steiger-systems/TempWatch/V1/Output-Files/BOM-JLCPCB Assembly Order.xls

JLCPCB BOM Tool - BOM Matching
BOM name：BOM-JLCPCB Assembly Order.xlsx |  |  | Download Time：2026-01-14 13:53:26 |  |  |  | * Our matching results are updated in real-time, but stock and prices may change. If it's been over 24 hours, please re-match before placing your order.
PCB Assembled Qty：5 |  |  | Est. Total Price：63.9846
Your BOM |  |  |  |  | Matched Parts |  |  |  |  |  |  | Order Information
Top Designator | Bottom Designator | Comment | Footprint | JLCPCB Part # | Matches | Part # | Manufacturer | Footprint | Description | Category | Warning | JLCPCB Part # | Product link | Lib Type | Qty | Source | Total Price ($)
C1,C2 |  | 22pF | C0603 |  | Select by System | CL10C220JB8NNNC | Samsung Electro-Mechanics | 0603 | 22pF 50V C0G ±5% 0603 Multilayer Ceramic Capacitors MLCC - SMD/SMT ROHS | Multilayer Ceramic Capacitors MLCC - SMD/SMT |  | C1653 | https://jlcpcb.com/partdetail/2005-CL10C220JB8NNNC/C1653 | Basic | 20 | 20 JLCPCB | 0.082
C5 |  | 22uF | CAP-SMD_BD4.0-L4.3-W4.3-LS5.1-FD |  | Select by System | VZH220M1CTR-0406 | Lelon | SMD,D4xL5.7mm | -45℃~+105℃ 16V 2000hrs@105℃ 22uF 4mm 5.7mm ±20% SMD,D4xL5.7mm Aluminum Electrolytic Capacitors - SMD ROHS | Aluminum Electrolytic Capacitors - SMD |  | C176685 | https://jlcpcb.com/partdetail/Lelon-VZH220M1CTR0406/C176685 | Extended | 9 | 9 JLCPCB | 0.6003
C7,C4,C11,C3,C6 |  | 100nF | C0603 |  | Select by System | CC0603KRX7R9BB104 | YAGEO | 0603 | 100nF 50V X7R ±10% 0603 Multilayer Ceramic Capacitors MLCC - SMD/SMT ROHS | Multilayer Ceramic Capacitors MLCC - SMD/SMT |  | C14663 | https://jlcpcb.com/partdetail/YAGEO-CC0603KRX7R9BB104/C14663 | Basic | 35 | 35 JLCPCB | 0.0875
C8 |  | 47uF | C0603 |  | Select by System | GRM188R60J476ME15D | Murata Electronics | 0603 | 47uF 6.3V X5R ±20% 0603 Multilayer Ceramic Capacitors MLCC - SMD/SMT ROHS | Multilayer Ceramic Capacitors MLCC - SMD/SMT |  | C140782 | https://jlcpcb.com/partdetail/152108-GRM188R60J476ME15D/C140782 | Extended | 9 | 9 JLCPCB | 0.4959
C9 |  | 430pF | C0402 |  | Select by System | 0402N431J500CT | Walsin Tech Corp | 0402 | 430pF 50V NP0 ±5% 0402 Multilayer Ceramic Capacitors MLCC - SMD/SMT ROHS | Multilayer Ceramic Capacitors MLCC - SMD/SMT |  | C458865 | https://jlcpcb.com/partdetail/Walsin_TechCorp-0402N431J500CT/C458865 | Extended | 20 | 20 JLCPCB | 0.086
C10 |  | 10uF | C1206 |  | Select by System | CL31A106KBHNNNE | Samsung Electro-Mechanics | 1206 | 10uF 50V X5R ±10% 1206 Multilayer Ceramic Capacitors MLCC - SMD/SMT ROHS | Multilayer Ceramic Capacitors MLCC - SMD/SMT |  | C13585 | https://jlcpcb.com/partdetail/14236-CL31A106KBHNNNE/C13585 | Basic | 9 | 9 JLCPCB | 0.5319
C16,C15,C14 |  | 1uF | C0805 |  | Select by System | CL21B105KBFNNNE | Samsung Electro-Mechanics | 0805 | 1uF 50V X7R ±10% 0805 Multilayer Ceramic Capacitors MLCC - SMD/SMT ROHS | Multilayer Ceramic Capacitors MLCC - SMD/SMT |  | C28323 | https://jlcpcb.com/partdetail/29074-CL21B105KBFNNNE/C28323 | Basic | 25 | 25 JLCPCB | 0.2325
CN2,CN7,CN5,CN1,CN6,CN3,CN4,CN8 |  | SM03B-SRSS-TB(LF)(SN)(P) | CONN-SMD_SM03B-SRSS-TB-LF-SN-P |  | Select by Customer | SM03B-SRSS-TB(LF)(SN) | JST | SMD,P=1mm,卧贴 | -25℃~+85℃ 1 1A 1mm 1x3P 2.9mm 3 3P 4.32mm 50V 5mm Auxiliary Solder Pin Copper alloy PA SH Surface Mount, Right Angle Tin UL94V-0 White SMD,P=1mm,Surface Mount，Right Angle Wire To Board Connector ROHS | Wire To Board Connector |  | C160403 | https://jlcpcb.com/partdetail/JST-SM03B_SRSS_TB_LF_SN/C160403 | Extended | 42 | 42 JLCPCB | 7.203
CN10 |  | SM04B-SRSS-TB(LF)(SN) | CONN-SMD_4P-P1.00_SM04B-SRSS-TB-LF-SN |  | Select by System | SM04B-SRSS-TB(LF)(SN) | JST | SMD,P=1mm,卧贴 | -25℃~+85℃ 1 1A 1mm 1x4P 2.9mm 4 4.32mm 4P 50V 6mm Auxiliary Solder Pin Copper alloy PA SH Surface Mount, Right Angle Tin UL94V-0 White SMD,P=1mm,Surface Mount，Right Angle Wire To Board Connector ROHS | Wire To Board Connector |  | C160404 | https://jlcpcb.com/partdetail/JST-SM04B_SRSS_TB_LF_SN/C160404 | Extended | 5 | 5 JLCPCB | 0.976
CN11 |  | SM02B-PASS-1-TBT(LF)(SN) | CONN-SMD_SM02B-PASS-1-TBT-LF-SN |  | Select by System | SM02B-PASS-1-TBT(LF)(SN) | JST | SMD,P=2mm,卧贴 | -25℃~+85℃ 1 1x2P 2 250V 2P 2mm 3A 5.7mm 8mm Copper alloy PA PA Pillar、Auxiliary Solder Pin Surface Mount, Right Angle Tin UL94V-0 White SMD,P=2mm,Surface Mount，Right Angle Wire To Board Connector ROHS | Wire To Board Connector |  | C265416 | https://jlcpcb.com/partdetail/JST-SM02B_PASS_1_TBT_LF_SN/C265416 | Extended | 5 | 5 JLCPCB | 1.8865
D1 |  | B340A-13-F | SMA_L4.4-W2.6-LS5.0-RD |  | Select by System | B340A-13-F | Diodes Incorporated | SMA(DO-214AC) | -55℃~+150℃ 1 Independent 3A 40V 500mV@3A 500uA@40V 80A SMA(DO-214AC) Schottky Diodes ROHS | Schottky Diodes |  | C85098 | https://jlcpcb.com/partdetail/DiodesIncorporated-B340A_13F/C85098 | Extended | 9 | 9 JLCPCB | 0.5229
Q2,Q1 |  | BC817-25Q-7-F | SOT-23-3_L2.9-W1.3-P1.90-LS2.4-BR |  | Select by System | BC817-25Q-7-F | Diodes Incorporated | SOT-23 | -65℃~+150℃ 100@300mA,1.0V 100MHz 100nA 350mW 45V 500mA 5V 700mV NPN SOT-23 Bipolar (BJT) ROHS | Bipolar (BJT) |  | C559579 | https://jlcpcb.com/partdetail/DiodesIncorporated-BC817_25Q_7F/C559579 | Extended | 14 | 14 JLCPCB | 0.371
R2,R4,R7,R5,R1,R3,R8,R6 |  | 4.7k | R0603 |  | Select by Customer | FRC0603F4701TS | FOJAN | 0603 | -55℃~+155℃ 100mW 4.7kΩ 75V Thick Film Resistor ±1% ±100ppm/℃ 0603 Chip Resistor - Surface Mount ROHS | Chip Resistor - Surface Mount | 1.The comment (FRC0603F4701TS) of this part does not match the one (4.7k) provided in your BOM. Please confirm; | C2907034 | https://jlcpcb.com/partdetail/FOJAN-FRC0603F4701TS/C2907034 | Extended | 50 | 50 JLCPCB | 0.045
R10,R9,R19,R11,R18 |  | 100k | R0402 |  | Select by Customer | CRCW0402100KFKED | Vishay Intertech | 0402 | -55℃~+155℃ 100kΩ 50V 63mW Thick Film Resistor ±1% ±100ppm/℃ 0402 Chip Resistor - Surface Mount ROHS | Chip Resistor - Surface Mount | 1.The comment (CRCW0402100KFKED) of this part does not match the one (100k) provided in your BOM. Please confirm; | C481918 | https://jlcpcb.com/partdetail/VishayIntertech-CRCW0402100KFKED/C481918 | Extended | 35 | 35 JLCPCB | 0.1225
R14,R15 |  | 5.1k | R0603 |  | Select by Customer | 0603WAF5101T5E | UNI-ROYAL(Uniroyal Elec) | 0603 | -55℃~+155℃ 100mW 5.1kΩ 75V Thick Film Resistor ±1% ±100ppm/℃ 0603 Chip Resistor - Surface Mount ROHS | Chip Resistor - Surface Mount | 1.The comment (0603WAF5101T5E) of this part does not match the one (5.1k) provided in your BOM. Please confirm; | C23186 | https://jlcpcb.com/partdetail/23913-0603WAF5101T5E/C23186 | Basic | 20 | 20 JLCPCB | 0.022
R17,R12,R16,R13 |  | 10k | R0603 |  | Select by Customer | 0603WAF1002T5E | UNI-ROYAL(Uniroyal Elec) | 0603 | -55℃~+155℃ 100mW 10kΩ 75V Thick Film Resistor ±1% ±100ppm/℃ 0603 Chip Resistor - Surface Mount ROHS | Chip Resistor - Surface Mount | 1.The comment (0603WAF1002T5E) of this part does not match the one (10k) provided in your BOM. Please confirm; | C25804 | https://jlcpcb.com/partdetail/26547-0603WAF1002T5E/C25804 | Basic | 30 | 30 JLCPCB | 0.033
R20 |  | 309k | R0402 |  | Select by Customer | FRC0402F3093TS | FOJAN | 0402 | -55℃~+155℃ 309kΩ 50V 62.5mW Thick Film Resistor ±1% ±100ppm/℃ 0402 Chip Resistor - Surface Mount ROHS | Chip Resistor - Surface Mount | 1.The comment (FRC0402F3093TS) of this part does not match the one (309k) provided in your BOM. Please confirm; | C5713270 | https://jlcpcb.com/partdetail/FOJAN-FRC0402F3093TS/C5713270 | Extended | 20 | 20 JLCPCB | 0.01
R21 |  | 10 | R0603 |  | Select by Customer | ERJ3GEYJ100V | PANASONIC | 0603 | -55℃~+155℃ 100mW 10Ω 75V Thick Film Resistor ±200ppm/℃ ±5% 0603 Chip Resistor - Surface Mount ROHS | Chip Resistor - Surface Mount | 1.The comment (ERJ3GEYJ100V) of this part does not match the one (10) provided in your BOM. Please confirm; | C403411 | https://jlcpcb.com/partdetail/PANASONIC-ERJ3GEYJ100V/C403411 | Extended | 20 | 20 JLCPCB | 0.106
R26,R24 |  | 0 | R1206 |  | Select by Customer | FRC1206P000 TS | FOJAN | 1206 | -55℃~+155℃ 0Ω 200V 250mW Thick Film Resistor ±5% 1206 Chip Resistor - Surface Mount ROHS | Chip Resistor - Surface Mount | 1.The comment (FRC1206P000 TS) of this part does not match the one (0) provided in your BOM. Please confirm; | C2907406 | https://jlcpcb.com/partdetail/FOJAN-FRC1206P000TS/C2907406 | Extended | 20 | 20 JLCPCB | 0.04
SW2,SW1 |  | KH-6X6X5H-STM | SW-SMD_4P-L6.0-W6.0-P4.50-LS9.0_H5.0 |  | Select by System | KH-6X6X5H-STM | Shenzhen Kinghelm Elec | SMD-4P,6x6mm | 12V 50mA 5mm 6mm 6mm 80,000 cycles Black Gull Wing Round Button SPST Surface Mount,Vertical Without Bracket SMD-4P,6x6mm Tactile Switches ROHS | Tactile Switches |  | C2837531 | https://jlcpcb.com/partdetail/Shenzhen_KinghelmElec-KH_6X6X5HSTM/C2837531 | Extended | 11 | 11 JLCPCB | 0.1881
U1 |  | MCP2515-I/ST | TSSOP-20_L6.5-W4.4-P0.65-LS6.4-BL |  | Select by System | MCP2515-I/ST | Microchip Tech | TSSOP-20 | -40℃~+85℃ 1Mbps 2.7V~5.5V 5mA CAN Controller TSSOP-20 CAN Controllers ROHS | CAN Controllers |  | C15193 | https://jlcpcb.com/partdetail/MicrochipTech-MCP2515_IST/C15193 | Extended | 5 | 5 JLCPCB | 8.234
U2 |  | SN65HVD230D | SOIC-8_L4.9-W3.9-P1.27-LS6.0-BL |  | Select by System | SN65HVD230D | Texas Instruments | SOIC-8 | -40℃~+85℃ 17mA 1Mbps 370uA 3V~3.6V CAN Transceiver SOIC-8 CAN Transceivers ROHS | CAN Transceivers |  | C1543812 | https://jlcpcb.com/partdetail/TexasInstruments-SN65HVD230D/C1543812 | Extended | 5 | 5 JLCPCB | 3.3655
U4 |  | ESP32-S3-WROOM-1(N8R2) | WIRELM-SMD_ESP32-S3-WROOM-1 |  | Unconfirmed | ESP32-S3-WROOM-1-N8R2 | Espressif Systems | SMD,25.5x18mm | -40℃~+85℃ -98.2dBm 2.4GHz 20.5dBm 355mA 3V~3.6V 97mA Bluetooth5.0 ESP32-S3 Chip On-board PCB Antenna UART、SPI、I2C、I2S、USB SMD,25.5x18mm WiFi Modules ROHS | WiFi Modules | 1.The comment (ESP32-S3-WROOM-1-N8R2) of this part does not match the one (ESP32-S3-WROOM-1(N8R2)) provided in your BOM. Please confirm; | C2913204 | https://jlcpcb.com/partdetail/3198302-ESP32_S3_WROOM_1N8R2/C2913204 | Extended | 5 | 5 JLCPCB | 23.5345
U5 |  | YTC-TC16S-24 | USB-C-SMD_YTC-TC16S-24 |  | Select by System | YTC-TC16S-24 | YIYUAN | SMD | -20℃~+85℃ 1 16P 3A、5A 5,000 times、10,000 cycles 5V 7.3mm Female Surface Mount, Right Angle Type-C SMD USB Connectors ROHS | USB Connectors |  | C2927291 | https://jlcpcb.com/partdetail/YIYUAN-YTC_TC16S24/C2927291 | Extended | 5 | 5 JLCPCB | 0.649
U6 |  | CP2102N-A02-GQFN28R | QFN-28_L5.0-W5.0-P0.50-TL-EP3.3 |  | Select by System | CP2102N-A02-GQFN28R | SKYWORKS/SILICON LABS | QFN-28-EP(5x5) | -40℃~+85℃@(Ta) 1.3uA 3V~3.6V 9.5mA USB 2.0 USB to UART QFN-28-EP(5x5) USB Converters ROHS | USB Converters |  | C964632 | https://jlcpcb.com/partdetail/1049893-CP2102N_A02GQFN28R/C964632 | Extended | 5 | 5 JLCPCB | 7.9835
U7 |  | TPS82130SILR | USIP-8_L3.0-W2.8-P0.65-TL-EP |  | Select by System | TPS82130SILR | Texas Instruments | USIP-8 | -40℃~+125℃ 1 1.5mm 2.8mm 20uA 2MHz 3A 3V~17V 3mm 900mV~6V Buck Over Temperature Protection ±1.5% USIP-8 DC-DC Power Modules ROHS | DC-DC Power Modules |  | C473914 | https://jlcpcb.com/partdetail/TexasInstruments-TPS82130SILR/C473914 | Extended | 5 | 5 JLCPCB | 4.8995
U9 |  | H7651-33PR | SOT-89-3_L4.5-W2.5-P1.50-LS4.1-BR |  | Select by System | H7651-33PR | Shanghai Siproin Microelectronics | SOT-89-3 | -40℃~+85℃ 1 1A 2uA 3.3V 60mV@(100mA) 8V Fixed Over Current Protection、Over Temperature Protection、Thermal Shutdown Positive SOT-89-3 Voltage Regulators - Linear, Low Drop Out (LDO) Regulators ROHS | Voltage Regulators - Linear, Low Drop Out (LDO) Regulators |  | C411050 | https://jlcpcb.com/partdetail/402215-H765133PR/C411050 | Extended | 7 | 7 JLCPCB | 0.8442
X2 |  | 10MHz | CRYSTAL-SMD_4P-L3.2-W2.5-BL |  | Select by System | T322510MLBDE2X | Yajingxin | SMD3225-4P | -30℃~+85℃ 10MHz 20pF 80Ω Crystal Oscillator ±10ppm ±30ppm SMD3225-4P Crystals ROHS | Crystals |  | C20885049 | https://jlcpcb.com/partdetail/Yajingxin-T322510MLBDE2X/C20885049 | Extended | 7 | 7 JLCPCB | 0.8323
H1 |  | 1x6 | HDR-TH_6P-P2.54-V-M-1 |  | Unconfirmed | 10897061 | MOLEX | 插件,P=2.54mm | 2 2.29mm 2.54mm 2.54mm 2.71mm 6.1mm 6P Black Copper alloy Pin Header Through Hole Tin Plugin,P=2.54mm Pin Headers ROHS | Pin Headers | 1.The comment (10897061) of this part does not match the one (1x6) provided in your BOM. Please confirm; | C3327513 | https://jlcpcb.com/partdetail/MOLEX-10897061/C3327513 | Extended | 5 | 0 JLCPCB | 0
