steiger-systems/TempWatch/V1/TempWatchtV1.kicad_pcb

## KiCad design V1/TempWatchtV1.kicad_pcb (2026-01-19)

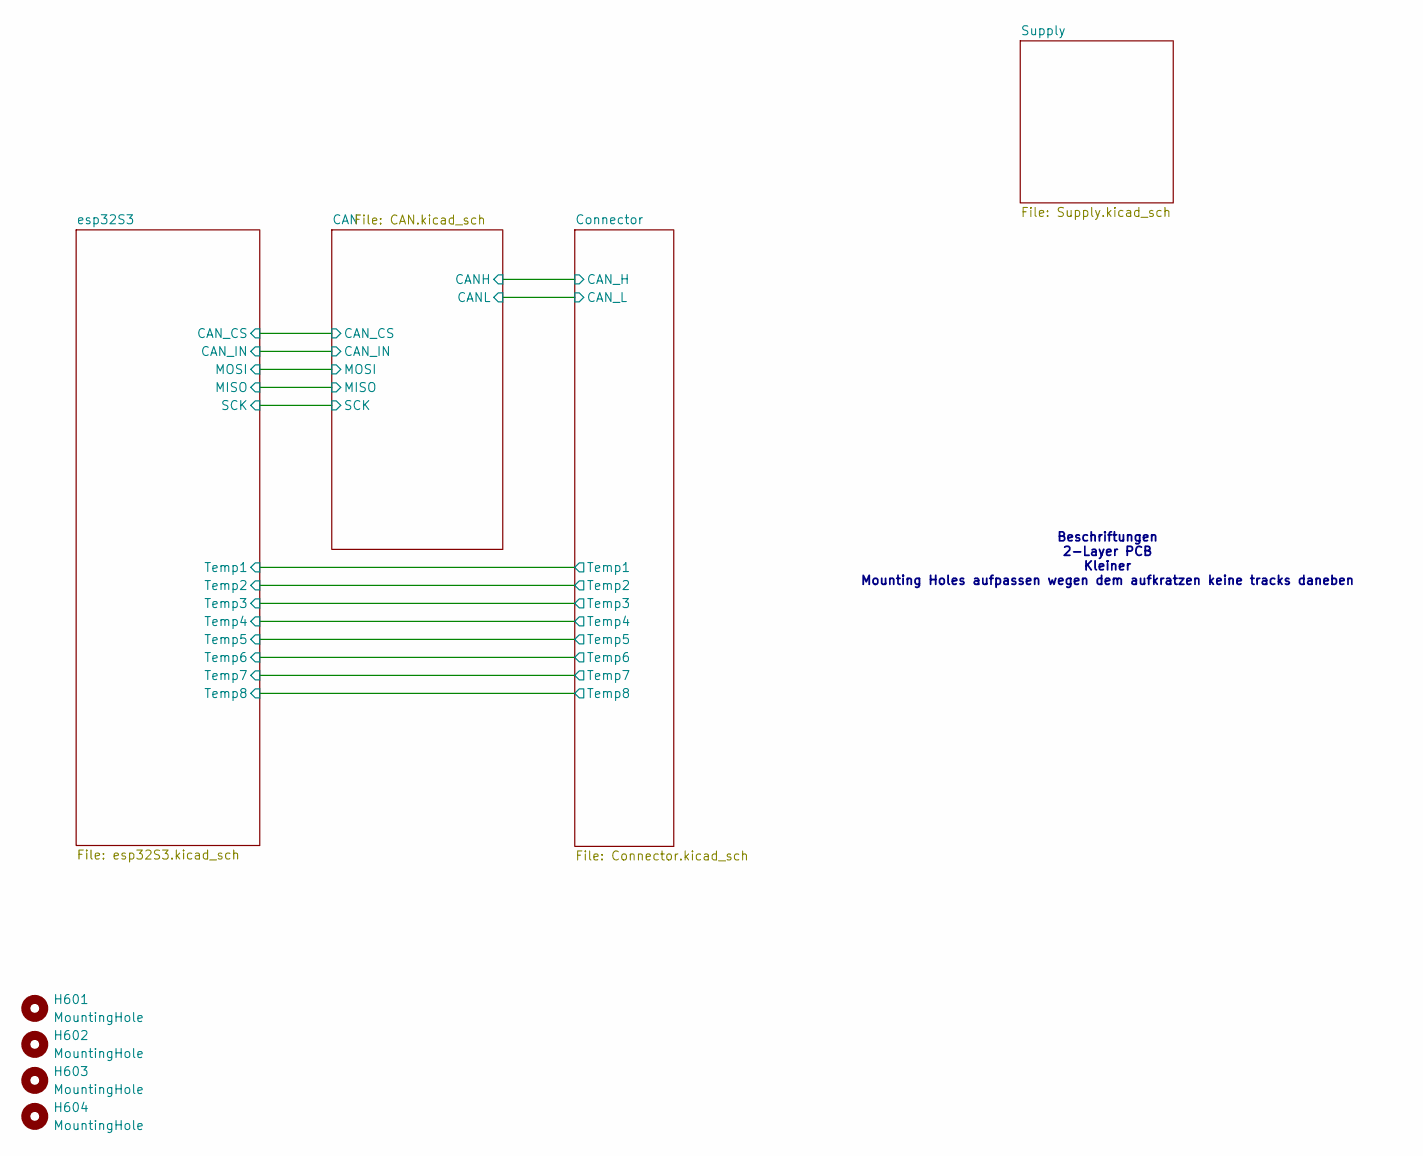
[picture p1: schematic TempWatchtV1.kicad_sch]

Parts:
H601, H602, H603, H604: MountingHole; MountingHole_3.2mm_M3_DIN965

Notes on the sheet:
Beschriftungen 2-Layer PCB Kleiner Mounting Holes aufpassen wegen dem aufkratzen keine tracks daneben

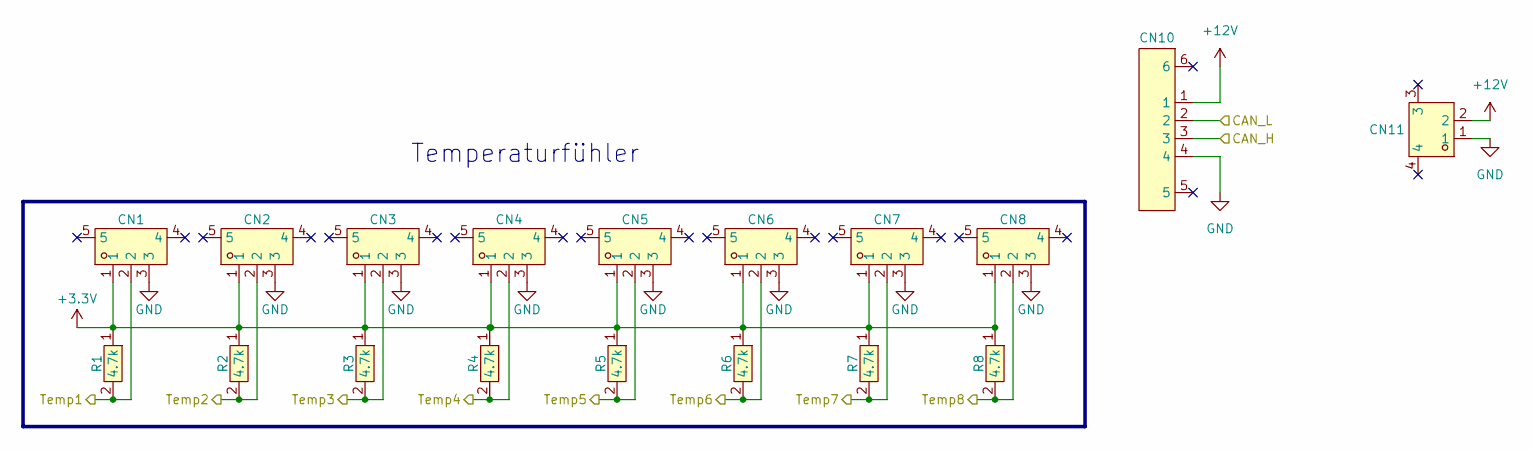
[picture p2: schematic Connector.kicad_sch]

Parts:
CN1, CN2, CN3, CN4, CN5, CN6, CN7, CN8: SM03B-SRSS-TB(LF)(SN)(P); CONN-SMD_SM03B-SRSS-TB-LF-SN-P; LCSC Part C160403
CN10: SM04B-SRSS-TB (LF)(SN); CONN-SMD_4P-P1.00_SM04B-SRSS-TB-LF-SN; LCSC Part C160404
CN11: SM02B-PASS-1-TBT(LF)(SN); CONN-SMD_SM02B-PASS-1-TBT-LF-SN; LCSC Part C265416
R1, R2, R3, R4, R5, R6, R7, R8: 4.7k; R0603; LCSC Part C2907034

Connections:
+3.3V: CN1.1, CN2.1, CN3.1, CN4.1, CN5.1, CN6.1, CN7.1, CN8.1, R1.1, R2.1, R3.1, R4.1, R5.1, R6.1, R7.1, R8.1; also elsewhere on the board
+12V: CN10.1, CN11.2; also elsewhere on the board
/CAN/CANH: CN10.3; also elsewhere on the board
/CAN/CANL: CN10.2; also elsewhere on the board
/Connector/Temp1: CN1.2, R1.2; also elsewhere on the board
/Connector/Temp2: CN2.2, R2.2; also elsewhere on the board
/Connector/Temp3: CN3.2, R3.2; also elsewhere on the board
/Connector/Temp4: CN4.2, R4.2; also elsewhere on the board
/Connector/Temp5: CN5.2, R5.2; also elsewhere on the board
/Connector/Temp6: CN6.2, R6.2; also elsewhere on the board
/Connector/Temp7: CN7.2, R7.2; also elsewhere on the board
/Connector/Temp8: CN8.2, R8.2; also elsewhere on the board
GND: CN1.3, CN2.3, CN3.3, CN4.3, CN5.3, CN6.3, CN7.3, CN8.3, CN10.4, CN11.1; also elsewhere on the board

Notes on the sheet:
Temperaturfühler

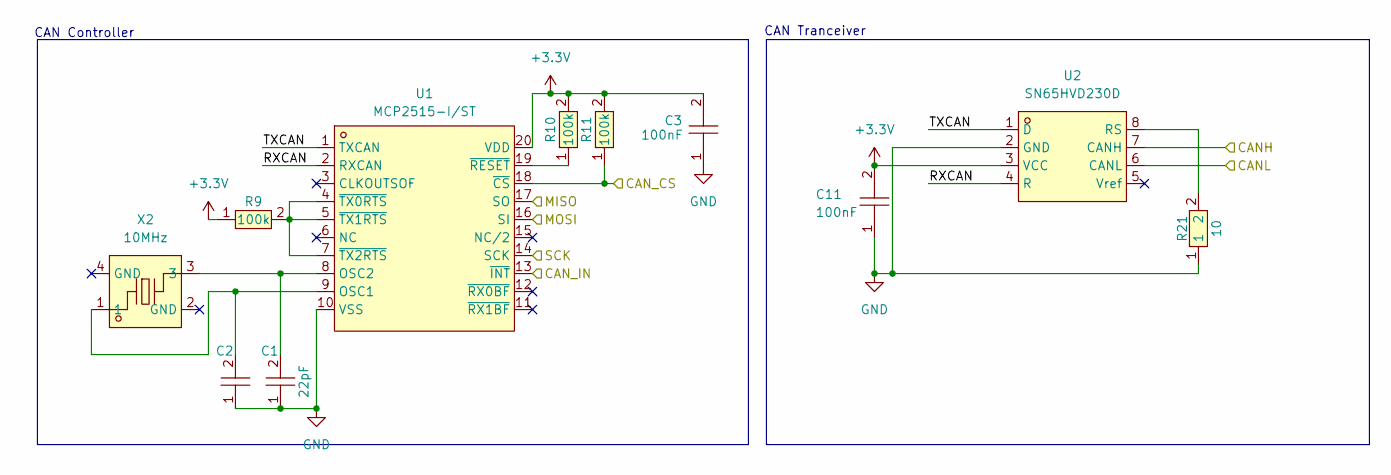
[picture p3: schematic CAN.kicad_sch]

Parts:
C1, C2: 22pF; C0603; LCSC Part C105620
C3, C11: 100nF; C0603; LCSC Part C14663
R9, R10, R11: 100k; R0402; LCSC Part C481918
R21: 10; R0603; LCSC Part C403411
U1: MCP2515-I/ST; TSSOP-20_L6.5-W4.4-P0.65-LS6.4-BL; LCSC Part C15193
U2: SN65HVD230D; SOIC-8_L4.9-W3.9-P1.27-LS6.0-BL; LCSC Part C1543812
X2: 10MHz; CRYSTAL-SMD_4P-L3.2-W2.5-BL; LCSC Part C20885034

Connections:
+3.3V: C3.2, C11.2, R9.1, R10.2, R11.2, U1.20 (VDD), U2.3 (VCC); also elsewhere on the board
/CAN/CANH: U2.7 (CANH); also elsewhere on the board
/CAN/CANL: U2.6 (CANL); also elsewhere on the board
/CAN/CAN_CS: R11.1, U1.18 (~CS); also elsewhere on the board
/CAN/CAN_IN: U1.13 (~INT); also elsewhere on the board
/CAN/MISO: U1.17 (SO); also elsewhere on the board
/CAN/MOSI: U1.16 (SI); also elsewhere on the board
/CAN/RXCAN: U1.2 (RXCAN), U2.4 (R)
/CAN/SCK: U1.14 (SCK); also elsewhere on the board
/CAN/TXCAN: U1.1 (TXCAN), U2.1 (D)
GND: C1.1, C2.1, C3.1, C11.1, R21.1, U1.10 (VSS), U2.2 (GND); also elsewhere on the board
unnamed: C2.2, U1.9 (OSC1), X2.1
unnamed: C1.2, U1.8 (OSC2), X2.3
unnamed: R10.1, U1.19 (~RESET)
unnamed: R9.2, U1.4 (~TX0RTS), U1.5 (~TX1RTS), U1.7 (~TX2RTS)
unnamed: R21.2, U2.8 (RS)

Notes on the sheet:
CAN Tranceiver
CAN Controller

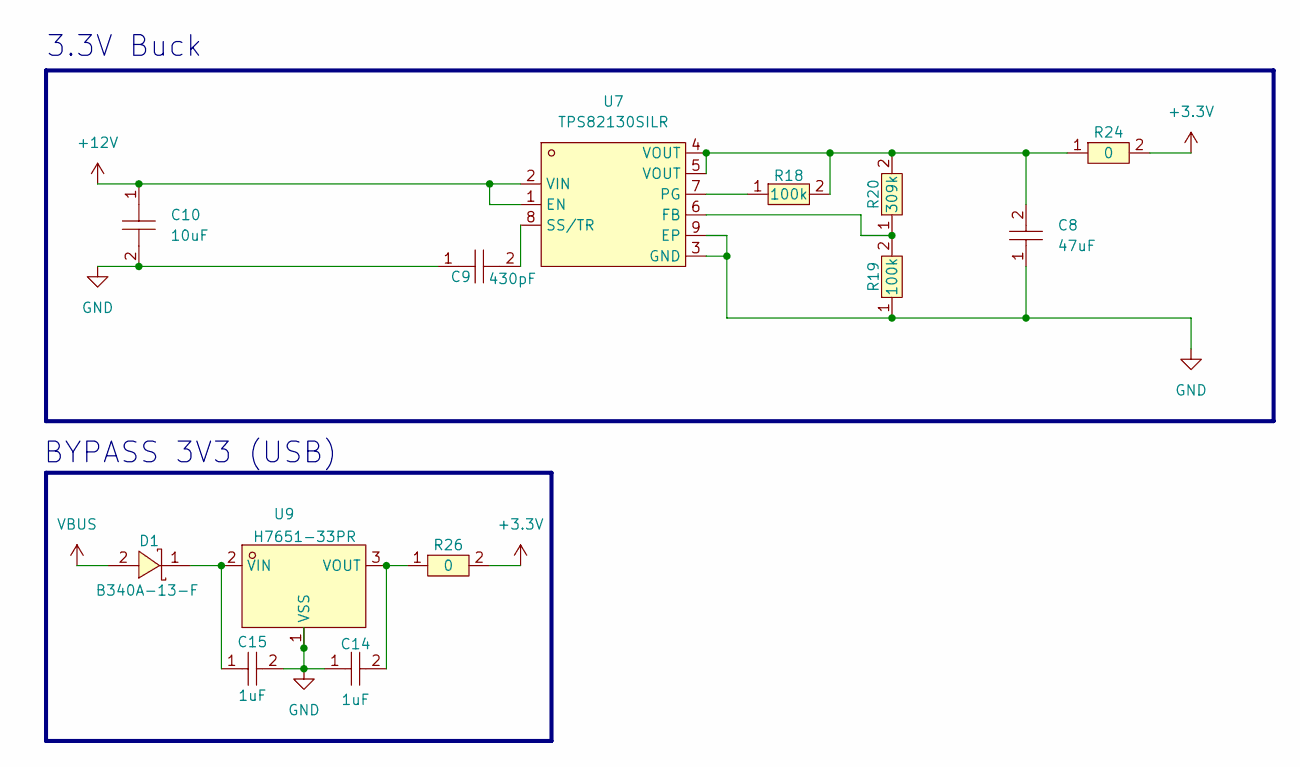
[picture p4: schematic Supply.kicad_sch]

Parts:
C8: 47uF; C0603; LCSC Part C140782
C9: 430pF; C0402; LCSC Part C2193561
C10: 10uF; C1206; LCSC Part C89632
C14, C15: 1uF; C0805; LCSC Part C28323
D1: B340A-13-F; SMA_L4.4-W2.6-LS5.0-RD; LCSC Part C85098
R18, R19: 100k; R0402; LCSC Part C481918
R20: 309k; R0402; LCSC Part C5713270
R24, R26: 0; R1206; LCSC Part C2907406
U7: TPS82130SILR; USIP-8_L3.0-W2.8-P0.65-TL-EP; LCSC Part C473914
U9: H7651-33PR; SOT-89-3_L4.5-W2.5-P1.50-LS4.1-BR; LCSC Part C411050

Connections:
+3.3V: R24.2, R26.2; also elsewhere on the board
+12V: C10.1, U7.1 (EN), U7.2 (VIN); also elsewhere on the board
GND: C8.1, C9.1, C10.2, C14.1, C15.2, R19.1, U7.3 (GND), U7.9 (EP), U9.1 (VSS); also elsewhere on the board
unnamed: C8.2, R18.2, R20.2, R24.1, U7.4 (VOUT), U7.5 (VOUT)
unnamed: C15.1, D1.1 (K), U9.2 (VIN)
unnamed: R19.2, R20.1, U7.6 (FB)
unnamed: R18.1, U7.7 (PG)
unnamed: C9.2, U7.8 (SS/TR)
unnamed: C14.2, R26.1, U9.3 (VOUT)
VBUS: D1.2 (A); also elsewhere on the board

Notes on the sheet:
BYPASS 3V3 (USB)
3.3V Buck

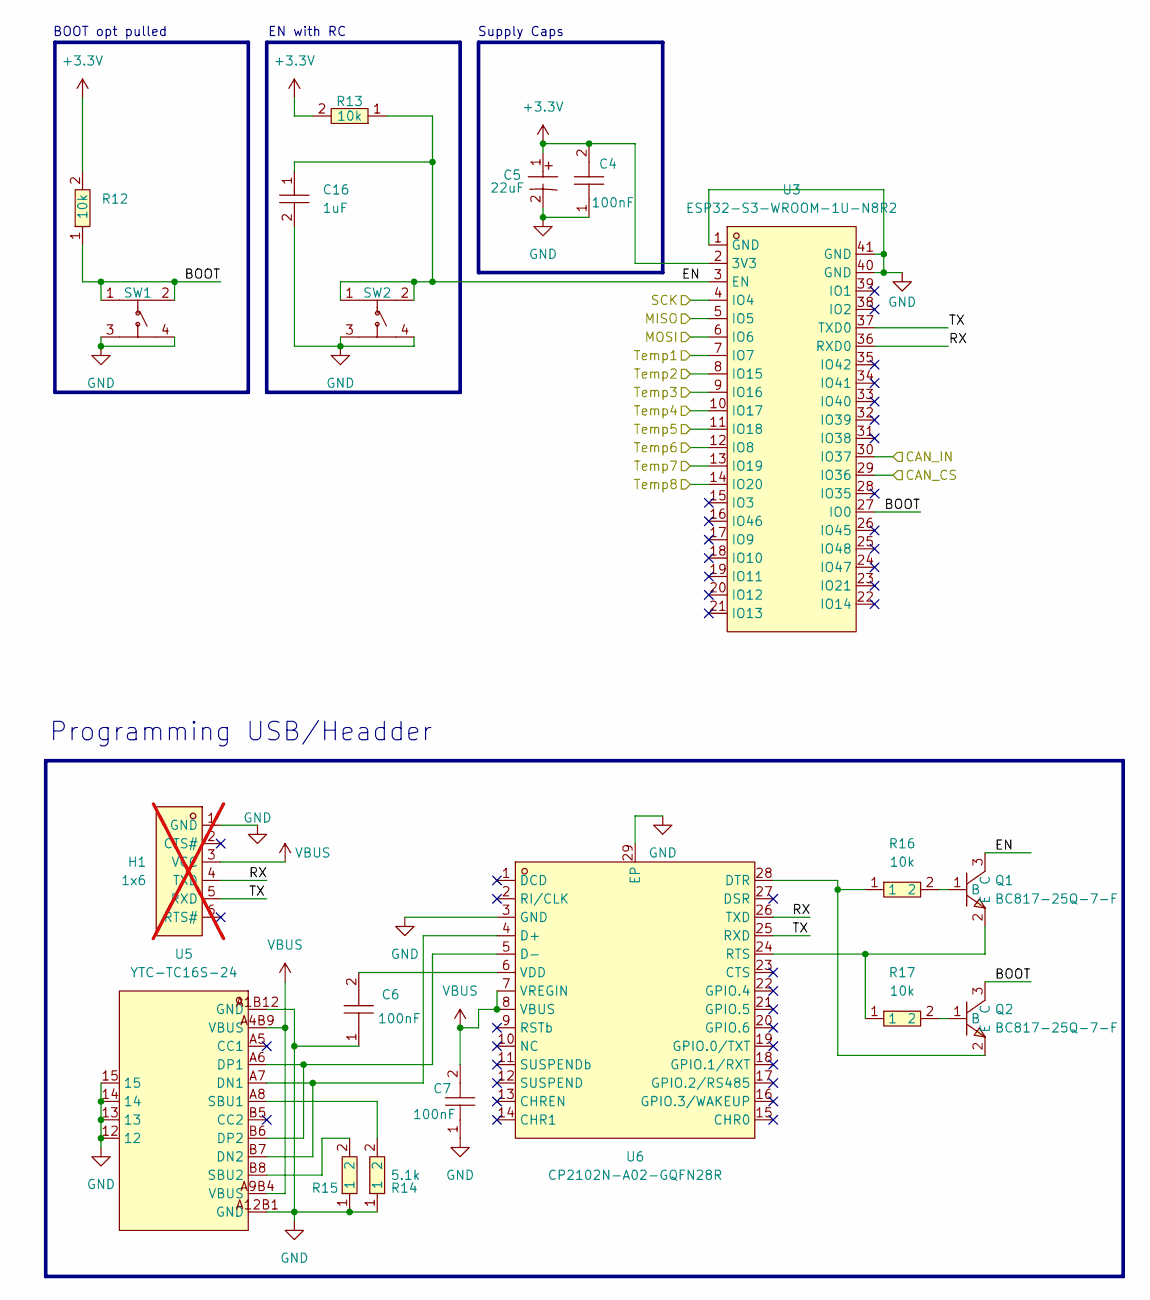
[picture p5: schematic esp32S3.kicad_sch]

Parts:
C4, C6, C7: 100nF; C0603; LCSC Part C14663
C5: 22uF; CAP-SMD_BD4.0-L4.3-W4.3-LS5.1-FD; LCSC Part C131114
C16: 1uF; C0805; LCSC Part C28323
H1: 1x6; HDR-TH_6P-P2.54-V-M-1; LCSC Part C42431796; not fitted
Q1, Q2: BC817-25Q-7-F; SOT-23-3_L2.9-W1.3-P1.90-LS2.4-BR; LCSC Part C559579
R12, R13, R16, R17: 10k; R0603; LCSC Part C98220
R14, R15: 5.1k; R0603; LCSC Part C186203
SW1, SW2: KH-6X6X5H-STM; SW-SMD_4P-L6.0-W6.0-P4.50-LS9.0_H5.0; LCSC Part C2837531
U3: ESP32-S3-WROOM-1U-N8R2; WIRELM-SMD_ESP32-S3-WROOM-1U; LCSC Part C3013944
U5: YTC-TC16S-24; USB-C-SMD_YTC-TC16S-24; LCSC Part C2927291
U6: CP2102N-A02-GQFN28R; QFN-28_L5.0-W5.0-P0.50-TL-EP3.3; LCSC Part C964632

Connections:
+3.3V: C4.2, C5.1, R12.2, R13.2, U3.2 (3V3); also elsewhere on the board
/CAN/CAN_CS: U3.29 (IO36); also elsewhere on the board
/CAN/CAN_IN: U3.30 (IO37); also elsewhere on the board
/CAN/MISO: U3.5 (IO5); also elsewhere on the board
/CAN/MOSI: U3.6 (IO6); also elsewhere on the board
/CAN/SCK: U3.4 (IO4); also elsewhere on the board
/Connector/Temp1: U3.7 (IO7); also elsewhere on the board
/Connector/Temp2: U3.8 (IO15); also elsewhere on the board
/Connector/Temp3: U3.9 (IO16); also elsewhere on the board
/Connector/Temp4: U3.10 (IO17); also elsewhere on the board
/Connector/Temp5: U3.11 (IO18); also elsewhere on the board
/Connector/Temp6: U3.12 (IO8); also elsewhere on the board
/Connector/Temp7: U3.13 (IO19); also elsewhere on the board
/Connector/Temp8: U3.14 (IO20); also elsewhere on the board
/esp32S3/BOOT: Q2.3 (C), R12.1, SW1.1, SW1.2, U3.27 (IO0)
/esp32S3/EN: C16.1, Q1.3 (C), R13.1, SW2.1, SW2.2, U3.3 (EN)
/esp32S3/RX: H1.4 (TXD), U3.36 (RXD0), U6.26 (TXD)
/esp32S3/TX: H1.5 (RXD), U3.37 (TXD0), U6.25 (RXD)
GND: C4.1, C5.2, C6.1, C7.1, C16.2, H1.1 (GND), R14.1, R15.1, SW1.3, SW1.4, SW2.3, SW2.4, U3.1 (GND), U3.40 (GND), U3.41 (GND), U5.12, U5.13, U5.14, U5.15, U5.A1B12 (GND), U5.A12B1 (GND), U6.3 (GND), U6.29 (EP); also elsewhere on the board
unnamed: Q1.1 (B), R16.2
unnamed: Q1.2 (E), R17.1, U6.24 (RTS)
unnamed: Q2.1 (B), R17.2
unnamed: Q2.2 (E), R16.1, U6.28 (DTR)
unnamed: U5.A7 (DN1), U5.B7 (DN2), U6.4 (D+)
unnamed: U5.A6 (DP1), U5.B6 (DP2), U6.5 (D-)
unnamed: R14.2, U5.A8 (SBU1)
unnamed: R15.2, U5.B8 (SBU2)
unnamed: C6.2, U6.6 (VDD)
VBUS: C7.2, H1.3 (VCC), U5.A4B9 (VBUS), U5.A9B4 (VBUS), U6.7 (VREGIN), U6.8 (VBUS); also elsewhere on the board

Notes on the sheet:
Supply Caps
EN with RC
BOOT opt pulled
Programming USB/Headder

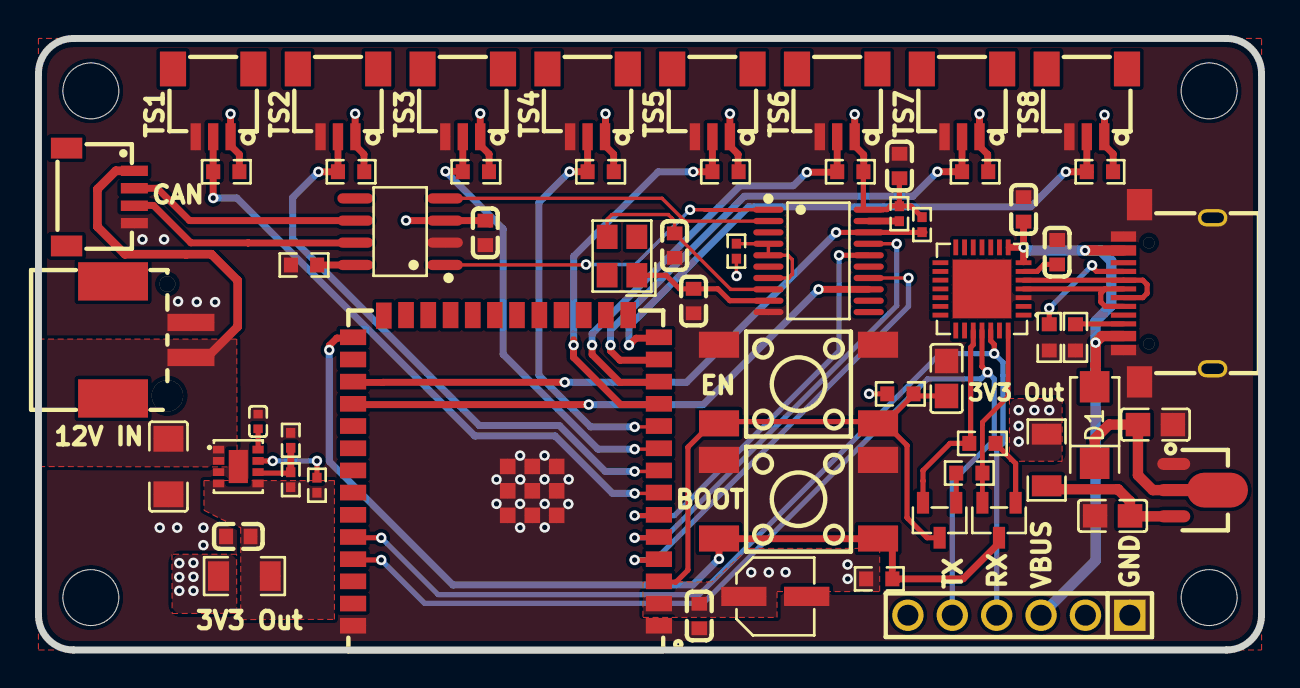
[picture p6: board TempWatchtV1.kicad_pcb from above]

Board: 4 copper layers, 70.0 x 35.0 mm, 65 parts (0 on the bottom side), 45 nets.
